margwoz/373WiiFitBoard---TC97_Forked/Maze/Core/Src/main.c

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
/* Includes ------------------------------------------------------------------*/
#include "main.h"

/* USER CODE BEGIN Includes */
#include <math.h>
#include <stdlib.h>
#include <string.h>
#include <stdio.h>
#include "MAX7219Driver.h"
#include "audio.h"
/* USER CODE END Includes */

/* USER CODE BEGIN PD */
#define STEP_SIZE 1.8
#define MAX_ARR 1999
#define MIN_ARR 1499

extern unsigned char output_pcm[];
extern unsigned int output_pcm_len;

/* USER CODE END PD */

DAC_HandleTypeDef hdac1;
DMA_HandleTypeDef hdma_dac1_ch1;

UART_HandleTypeDef hlpuart1;
UART_HandleTypeDef huart5;
UART_HandleTypeDef huart2;

SPI_HandleTypeDef hspi1;

TIM_HandleTypeDef htim3;
TIM_HandleTypeDef htim4;
TIM_HandleTypeDef htim5;
TIM_HandleTypeDef htim6;
TIM_HandleTypeDef htim7;

/* USER CODE BEGIN PV */

int32_t elapsed_time = -1; //start at -1 to handle delay between timer start and display

/* USER CODE END PV */

void SystemClock_Config(void);
static void MX_GPIO_Init(void);
static void MX_DMA_Init(void);
static void MX_USART2_UART_Init(void);
static void MX_UART5_Init(void);
static void MX_LPUART1_UART_Init(void);
static void MX_SPI1_Init(void);
static void MX_TIM4_Init(void);
static void MX_TIM3_Init(void);
static void MX_TIM7_Init(void);
static void MX_TIM6_Init(void);
static void MX_DAC1_Init(void);
static void MX_TIM5_Init(void);
/* USER CODE BEGIN 0 */

// Wireless Transfer Data
int8_t rx_byte[2] = { 0, 0 };
volatile int received_roll = 0;
volatile int received_pitch = 0;
volatile uint8_t msg_flag = 0;
volatile uint8_t mov_flag1 = 0;
volatile uint8_t mov_flag2 = 0;


// Motor Movement Data
volatile int32_t steps_left1 = 0;
volatile int32_t steps_left2 = 0;
volatile int32_t steps_to_take1 = 0;
volatile int32_t steps_to_take2 = 0;
volatile uint32_t current_arr1 = MAX_ARR;
volatile uint32_t current_arr2 = MAX_ARR;
volatile uint32_t arr_step1 = 0;
volatile uint32_t arr_step2 = 0;
volatile int current_roll = 0;
volatile int current_pitch= 0;

//CoM display
volatile int time_update=0; //to actually update time
volatile int clear_flag=0; //clear flag to wipe display between rdy->mov transition

// Game State Data
volatile uint8_t game_ongoing = 0; //start at 0, update to 1 once board status flips

typedef enum
{
	TARE, //taring status from board
	RDY, //ready status from board
	MOV, //moving status from board
	END //game end status from beam break
} player_status; //enum to indicate if someone is on or off the board


player_status board = TARE; //start with the board in taring state


/* USER CODE END 0 */

/**
  * @brief  The application entry point.
  * @retval int
  */
int main(void)
{

  /* MCU Configuration--------------------------------------------------------*/

  /* Reset of all peripherals, Initializes the Flash interface and the Systick. */
  HAL_Init();

  /* Configure the system clock */
  SystemClock_Config();

  /* Initialize all configured peripherals */
  MX_GPIO_Init();
  MX_DMA_Init();
  MX_USART2_UART_Init();
  MX_UART5_Init();
  MX_LPUART1_UART_Init();
  MX_SPI1_Init();
  MX_TIM4_Init();
  MX_TIM3_Init();
  MX_TIM7_Init();
  MX_TIM6_Init();
  MX_DAC1_Init();
  MX_TIM5_Init();
  /* USER CODE BEGIN 2 */

  HAL_UART_Receive_IT(&huart5, rx_byte, 2); //enable reception from the wireless

  Matrix_Init(); //start the display

  HAL_GPIO_WritePin(EN1_GPIO_Port, EN1_Pin, GPIO_PIN_RESET); //enable motor 1
  HAL_GPIO_WritePin(EN2_GPIO_Port, EN2_Pin, GPIO_PIN_RESET); //enable motor 2

  int dir1 = 0; //direction of roll motor
  int dir2 = 0; //direction of pitch motor
  int diff1 = 0; //roll difference
  int diff2 = 0; //pitch difference
  int sign1 = 0; //addition/subtraction (1,-1) for roll
  int sign2 = 0; //addition/subtraction (1,-1) for pitch


  /* USER CODE END 2 */

  /* Infinite loop */
  /* USER CODE BEGIN WHILE */
  while (1)
  {
    /* USER CODE END WHILE */

    /* USER CODE BEGIN 3 */
	  if(board==TARE) //if taring
	  {
		  if(game_ongoing == 1) //if someone stepped off mid game
		  {
			  	if(current_roll!=0) //if roll not zeroed
			  	{
			  		//move motor back to zero
			  		dir1  = (current_roll - 0 > 0) ? 1 : 0;
			  		diff1 = (abs(current_roll - 0));
			  		steps_left1 = steps_to_take1 = 2 * diff1;
			  		arr_step1 = (MAX_ARR - MIN_ARR) / ( (steps_to_take1) / 3 ) ;
			  		HAL_GPIO_WritePin(DIR1_GPIO_Port, DIR1_Pin, dir1);
			  		HAL_TIM_Base_Start_IT(&htim6);
			  		current_roll = 0;
			  	}

			  	if(current_pitch!=0) //if pitch not zeroed
			  	{
			  		//move motor back to zero
			  		dir2  = (current_pitch - 0 > 0) ? 1 : 0;
			  		diff2 = (abs(current_pitch - 0));
			  		steps_left2 = steps_to_take2 = 2 * diff2;
			  		arr_step2 = (MAX_ARR - MIN_ARR) / ( (steps_to_take2) / 3 ) ;
			  		HAL_GPIO_WritePin(DIR2_GPIO_Port, DIR2_Pin, dir2);
			  		HAL_TIM_Base_Start_IT(&htim7);
			  		current_pitch = 0;
			  	}
			  	game_ongoing=0; //reset to game not going
			  	HAL_TIM_Base_Stop_IT(&htim4); //stop timer
			  	elapsed_time = -1; //reset elapsed time
		  }

		  //write TARE to display
		  Write_Char(3,29);//T
		  Write_Char(2,10);//A
		  Write_Char(1,27);//R
		  Write_Char(0,14);//E
	  }

	  else if (board==RDY) //board ready for a user
	  {
		  //Write RDY:) to display
		  Write_Char(3,27);//R
		  Write_Char(2,13);//D
		  Write_Char(1,34);//Y
		  Write_Char(0,38);//:)
	  }

	  else if (board==MOV) //user on board
	  {
		  if (clear_flag) //if just transitioned from the rdy state
		  {
				HAL_TIM_Base_Start_IT(&htim4); //start timer
				Matrix_Clear(); //clear matrix
				Write_Char(3,0); //0
				Write_Char(2,0); //0
				Write_Char(1,0); //0
				clear_flag=0; //reset flag
		  }

		  //Update motors
		  if(msg_flag && !( mov_flag1 | mov_flag2 ) ) {
		 		  dir1  = (current_roll - received_roll > 0) ? 1 : 0; //roll direction logic
		 		  dir2  = (current_pitch - received_pitch > 0) ? 1 : 0; //pitch direction logic

		 		  //determine if we're adding or subtracting
		 		  sign1 = (dir1 == 0) ? 1 : -1; //get roll sign based on dir
		 		  sign2 = (dir2 == 0) ? 1 : -1; //get pitch sign based on dir

		 		  diff1 = (abs(current_roll - received_roll)); //get the roll delta
		 		  diff2 = (abs(current_pitch - received_pitch)); //get the pitch delta

		 		  //*2 bc using toggle so need 1 to turn on and 1 to turn off
		 		  steps_left1 = steps_to_take1 = 2 * diff1; //roll steps
		 		  steps_left2 = steps_to_take2 = 2 * diff2; //pitch steps

		 		  //Update ARR steps based on step range
		 		  arr_step1 = (MAX_ARR - MIN_ARR) / ( (steps_to_take1) / 3 ) ;
		 		  arr_step2 = (MAX_ARR - MIN_ARR) / ( (steps_to_take2) / 3 ) ;

		 		  HAL_GPIO_WritePin(DIR1_GPIO_Port, DIR1_Pin, dir1); //set roll direction
		 		  HAL_GPIO_WritePin(DIR2_GPIO_Port, DIR2_Pin, dir2); //set pitch direction

		 		  // Set move flags
		 		  mov_flag1 = mov_flag2 = 1;

		 		  HAL_TIM_Base_Start_IT(&htim6); //start timer for moving motors
		 		  HAL_TIM_Base_Start_IT(&htim7); //start timer for moving motors
		 		  current_roll += (sign1*diff1); //where roll actually is
		 		  current_pitch += (sign2*diff2); //where pitch actually is
		 	  }
	  }

	  else if(board==END) //board==END
	  {
		  	if(current_roll!=0) //if roll not zeroed
		  	{
		  		dir1  = (current_roll - 0 > 0) ? 1 : 0;
		  		diff1 = (abs(current_roll - 0));
		  		steps_left1 = steps_to_take1 = 2 * diff1;
		  		arr_step1 = (MAX_ARR - MIN_ARR) / ( (steps_to_take1) / 3 ) ;
		  		HAL_GPIO_WritePin(DIR1_GPIO_Port, DIR1_Pin, dir1);
		  		HAL_TIM_Base_Start_IT(&htim6);
		  		current_roll = 0;
		  	}

		  	if(current_pitch!=0) //if pitch not zeroed
		  	{
		  		dir2  = (current_pitch - 0 > 0) ? 1 : 0;
		  		diff2 = (abs(current_pitch - 0));
		  		steps_left2 = steps_to_take2 = 2 * diff2;
		  		arr_step2 = (MAX_ARR - MIN_ARR) / ( (steps_to_take2) / 3 ) ;
		  		HAL_GPIO_WritePin(DIR2_GPIO_Port, DIR2_Pin, dir2);
		  		HAL_TIM_Base_Start_IT(&htim7);
		  		current_pitch = 0;
		  	}

		  	//run audio
			HAL_TIM_Base_Start(&htim5);
			HAL_DAC_Start_DMA(&hdac1, DAC_CHANNEL_1, (uint32_t *)output_pcm, output_pcm_len, DAC_ALIGN_8B_R);

			//display transition
			Write_Char(0,39); //Heart to replace the center of mass w/ final time
			HAL_TIM_Base_Stop_IT(&htim4); //stop timer
			HAL_NVIC_EnableIRQ(UART5_IRQn); //re-enable the UART interrupt
			elapsed_time = -1; //reset elapsed time
	  }

  }

  /* USER CODE END 3 */
}

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
/* USER CODE BEGIN 4 */
#ifdef __GNUC__
#define PUTCHAR_PROTOTYPE int __io_putchar(int ch)
#else
  #define PUTCHAR_PROTOTYPE int fputc(int ch, FILE *f)
#endif /* __GNUC__ */
PUTCHAR_PROTOTYPE
{
  HAL_UART_Transmit(&hlpuart1, (uint8_t *)&ch, 1, 0xFFFF);
  return ch;
}

void HAL_UART_RxCpltCallback(UART_HandleTypeDef *huart)
{
	if(huart->Instance == UART5)
	{

		if(rx_byte[0]==87 && rx_byte[1]==87) //if receiving tare status from the board (status 87)
		{
			board = TARE; //set board status to tare, handle in main
		}

		else if (rx_byte[0]==89 && rx_byte[1]==89) //if received rdy status from the board (status 89)
		{
			board = RDY; //set board status to ready, handle in main
		}

		else //board has someone on it
		{

			//1st transition from RDY -> MOV
			if(board==RDY && game_ongoing==0)
			{
				board = MOV; //update the flag
				clear_flag = 1; //set flag
				game_ongoing = 1; //game has started
			}

		}
		//update received roll and pitch every time but should only move when status is MOV
		received_roll = rx_byte[0]; //update roll
		received_pitch = rx_byte[1]; //update pitch
		msg_flag = 1; //data ready
		HAL_UART_Receive_IT(&huart5, rx_byte, 2); //restart the uart every time no matter what state we're in
	}
}

void HAL_TIM_PeriodElapsedCallback(TIM_HandleTypeDef *htim){

	//Timer for Display (CoM and user time)
	//CoM updates ~20 times as fast as the time does
	//Time updates every second
	if (htim->Instance == TIM4)
	{
		//CoM Display
	    float mass_col = (4*((received_roll/70.0)+1)-1); //get col based on roll
		float mass_row = (4*((received_pitch/70.0)+1)-1); //get row based on pitch
		mass_row = (mass_row > 7) ?  7 : (mass_row < 0) ? 0 : mass_row; //bound checking on row
		mass_col = (mass_col > 7) ? 7 : (mass_col < 0) ? 0 : mass_col; //bound checking on col
		Matrix_Clear_Cell(0); //clear current CoM
		Write_Pixel(0, (int)mass_row, (int)mass_col); //write CoM

		//Time Display
		time_update++; //update universal timer
		if (time_update==20) //if need to update time display
		{
			elapsed_time++; //increase displayed time
			Write_Char(3, (elapsed_time / 100) % 10);
			Write_Char(2, (elapsed_time / 10) % 10);
			Write_Char(1, elapsed_time % 10);
			time_update=0; //reset
		}

	}

	//Timer for Motor 1
	if (htim->Instance == TIM6)
	{
		//If done moving stop/reset timer and clear flag
		if (steps_left1 <=0)
		{
			HAL_TIM_Base_Stop_IT(&htim6);
			TIM6->ARR = MAX_ARR;
			current_arr1 = MAX_ARR;
			mov_flag1 = 0;  //indicate we're ready to move again
		}

		// Accelerate for the first 3rd of steps
		if( steps_left1 <=  (steps_to_take1) * (2/3) ){
			current_arr1 -= arr_step1;
			TIM6->ARR = current_arr1;
		 //Hold speed for middle third
		}
		else if ( steps_left1 >= (steps_to_take1) * (1/3) ){

		 // Decelerate for final third
		}
		else{
			current_arr1 += arr_step1;
			TIM6->ARR = current_arr1;
		}

		if( steps_left1 > 0){
			HAL_GPIO_TogglePin(STP1_GPIO_Port, STP1_Pin);
			steps_left1--;
		}
	}

	//Timer for Motor 2
	if(htim->Instance == TIM7)
	{
		//If done moving stop/reset timer and clear flag
		if (steps_left2 <=0)
		{
			HAL_TIM_Base_Stop_IT(&htim7);
			current_arr2 = MAX_ARR;
			TIM7->ARR = MAX_ARR;
		    mov_flag2 = 0;    //indicate we're ready to move again
		}

		// Accelerate for the first 3rd of steps
		if( steps_left2 <=  (steps_to_take2) * (2/3) ){
			current_arr2 -= arr_step2;
			TIM7->ARR = current_arr2;
		 //Hold speed for middle third
		}else if ( steps_left2 >= (steps_to_take2) * (1/3) ){

		 // Decelerate for final third
		}else{
			current_arr2 += arr_step2;
			TIM7->ARR = current_arr2;
		}

		if(steps_left2 > 0){
		HAL_GPIO_TogglePin(STP2_GPIO_Port, STP2_Pin);
		steps_left2--;
		}
	}
}

//function to clear overrun flag
//added to account for the issue where we receive information before we clear the buffer
//has no affect on actual performance, only on buffer performance
void HAL_UART_ErrorCallback(UART_HandleTypeDef *huart)
{
    if (huart->Instance == UART5)
    {
        uint32_t err = HAL_UART_GetError(huart);

        if (err & HAL_UART_ERROR_ORE)
        {

            __HAL_UART_CLEAR_FLAG(huart, UART_CLEAR_OREF);
            __HAL_UART_SEND_REQ(huart, UART_RXDATA_FLUSH_REQUEST);
        }

        HAL_UART_Receive_IT(huart, rx_byte, 2);
    }
}


//Beam break interrupt code
void HAL_GPIO_EXTI_Callback(uint16_t GPIO_Pin)
{
  if (GPIO_Pin == BEAM_BREAK_Pin) { // GPIO_PIN_0 as beam button is external interrupt on PG0
  		if (game_ongoing) //if game to end
  		{
  			game_ongoing = 0; //game no longer active
  			board = END; //update board status, to be handled in main
  			HAL_NVIC_DisableIRQ(UART5_IRQn); //disable uart until game reset logic done in main
  	}

  }
}

/* USER CODE END 4 */
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
