margwoz/373WiiFitBoard---TC97_Forked/Maze/Core/Inc/main.h

#define BEAM_BREAK_TWO_Pin GPIO_PIN_8
#define BEAM_BREAK_TWO_GPIO_Port GPIOF
#define BEAM_BREAK_TWO_EXTI_IRQn EXTI9_5_IRQn
#define RST1_Pin GPIO_PIN_0
#define RST1_GPIO_Port GPIOC
#define STP1_Pin GPIO_PIN_1
#define STP1_GPIO_Port GPIOC
#define SLP_Pin GPIO_PIN_3
#define SLP_GPIO_Port GPIOC
#define EN1_Pin GPIO_PIN_3
#define EN1_GPIO_Port GPIOA
#define DIR1_Pin GPIO_PIN_4
#define DIR1_GPIO_Port GPIOC
#define CS_Pin GPIO_PIN_12
#define CS_GPIO_Port GPIOF
#define BEAM_BREAK_Pin GPIO_PIN_0
#define BEAM_BREAK_GPIO_Port GPIOG
#define BEAM_BREAK_EXTI_IRQn EXTI0_IRQn
#define EN2_Pin GPIO_PIN_3
#define EN2_GPIO_Port GPIOD
#define STP2_Pin GPIO_PIN_4
#define STP2_GPIO_Port GPIOD
#define DIR2_Pin GPIO_PIN_7
#define DIR2_GPIO_Port GPIOD
