margwoz/373WiiFitBoard---TC97_Forked/FitnessBoard/Core/Src/main.c

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
/* Includes ------------------------------------------------------------------*/
#include "main.h"

/* USER CODE BEGIN Includes */
#include "hx711.h"
#include "stdio.h"

/* USER CODE END Includes */

/* USER CODE BEGIN PD */
#define COEF1 6067.3
#define COEF2 5985.7
#define COEF3 6045.2
#define COEF4 5979.8
//Max amount of steps to normalize roll/pitch to. Increase for higher sense (careful not to over-rotate)
#define STEP_NORM 70.1 //MUST FIT IN int8_t [-128 to 127]
//Transmission CMDS (Outside of max normalized step boundary)
#define CMD_TARE 87
#define CMD_RDY 89
//Thresholds for state transition logic
#define PLAY_THRSH 10
#define MOVE_THRSH 5
#define TARE_THRSH 0.5
//Iteration counts for measurement samples and tare cycles
#define NUM_TARES 25
#define NUM_SAMPLES 1
//Dead zones for amplifier noise
#define LOWER_DZ 0.5
#define UPPER_DZ 500
//Tear delay in ms
#define TARE_DELAY 2000
#define PLAY_DELAY 1000
/* USER CODE END PD */

UART_HandleTypeDef huart2;
UART_HandleTypeDef huart6;

/* USER CODE BEGIN PV */
//Cell Init
hx711_t cell1, cell2, cell3, cell4;
//State machine for tare, ready, and play states
typedef enum {
	TARE,
	RDY,
	PLAY
} state_t;
//Status print array
const char *state_names[] = { "TARE", "RDY ", "PLAY" };
//Empty tick for tare delay
uint32_t tare_timer_start = 0;
uint32_t play_timer_start = 0;

/* USER CODE END PV */

void SystemClock_Config(void);
static void MX_GPIO_Init(void);
static void MX_USART2_UART_Init(void);
static void MX_USART6_UART_Init(void);
/**
 * @brief  The application entry point.
 * @retval int
 */
int main(void) {

	/* MCU Configuration--------------------------------------------------------*/

	/* Reset of all peripherals, Initializes the Flash interface and the Systick. */
	HAL_Init();

	/* Configure the system clock */
	SystemClock_Config();

	/* Initialize all configured peripherals */
	MX_GPIO_Init();
	MX_USART2_UART_Init();
	MX_USART6_UART_Init();
	/* USER CODE BEGIN 2 */
	//Cell1
	hx711_init(&cell1, clk1_GPIO_Port, clk1_Pin, cell1_GPIO_Port, cell1_Pin);
	hx711_coef_set(&cell1, COEF1); // read after calibration
	HAL_Delay(10);
	//Cell2
	hx711_init(&cell2, clk2_GPIO_Port, clk2_Pin, cell2_GPIO_Port, cell2_Pin);
	hx711_coef_set(&cell2, COEF2); // read after calibration
	HAL_Delay(10);
	//Cell3
	hx711_init(&cell3, clk3_GPIO_Port, clk3_Pin, cell3_GPIO_Port, cell3_Pin);
	hx711_coef_set(&cell3, COEF3); // read after calibration
	HAL_Delay(10);
	//Cell4
	hx711_init(&cell4, clk4_GPIO_Port, clk4_Pin, cell4_GPIO_Port, cell4_Pin);
	hx711_coef_set(&cell4, COEF4); // read after calibration
	HAL_Delay(10);

	//Initial tare before while()
	HAL_Delay(500);
	hx711_tare(&cell1, NUM_TARES);
	hx711_tare(&cell2, NUM_TARES);
	hx711_tare(&cell3, NUM_TARES);
	hx711_tare(&cell4, NUM_TARES);

	//Initial state
	state_t status = RDY;
	int8_t buffer[2] = { 0 };
	float weight1, weight2, weight3, weight4;
	/* USER CODE END 2 */

	/* Infinite loop */
	/* USER CODE BEGIN WHILE */
	while (1) {
		/* USER CODE END WHILE */

		/* USER CODE BEGIN 3 */
		//Wait for weight threshold
		weight1 = hx711_weight(&cell1, NUM_SAMPLES);
		weight2 = hx711_weight(&cell2, NUM_SAMPLES);
		weight3 = hx711_weight(&cell3, NUM_SAMPLES);
		weight4 = hx711_weight(&cell4, NUM_SAMPLES);

		//HALF LB dead zone
		if (weight1 < LOWER_DZ || weight1 > UPPER_DZ) weight1 = 0;
		if (weight2 < LOWER_DZ || weight2 > UPPER_DZ) weight2 = 0;
		if (weight3 < LOWER_DZ || weight3 > UPPER_DZ) weight3 = 0;
		if (weight4 < LOWER_DZ || weight4 > UPPER_DZ) weight4 = 0;

		//Calculate sum (NO DIVIDE BY 0)
		float sum = weight1 + weight2 + weight3 + weight4;

		//Pitch and roll math (NORMALIZED)
		int8_t pitch = 0;
		int8_t roll = 0;
		if (sum > 0) {
			pitch = STEP_NORM * (((weight1 + weight4) - (weight2 + weight3)) / sum);
			roll = STEP_NORM * (((weight1 + weight2) - (weight3 + weight4)) / sum);
		}

		//Test print
		//printf("cell1: %.2f | cell2: %.2f | cell3: %.2f | cell4: %.2f <-> roll: %i | pitch %i <-> STATUS: %s\n",
		//		weight1, weight2, weight3, weight4, buffer[0], buffer[1], state_names[status]);

		//State machine for TARE, RDY, and PLAY states
		switch (status) {
		  case TARE:
			//TARE transmission
			buffer[0] = CMD_TARE;
			buffer[1] = CMD_TARE;
			//Transmit command, wait for tare
			HAL_UART_Transmit(&huart6, (uint8_t*) buffer, 2, 100);
			hx711_tare(&cell1, NUM_TARES);
			HAL_UART_Transmit(&huart6, (uint8_t*) buffer, 2, 100);
			hx711_tare(&cell2, NUM_TARES);
			HAL_UART_Transmit(&huart6, (uint8_t*) buffer, 2, 100);
			hx711_tare(&cell3, NUM_TARES);
			HAL_UART_Transmit(&huart6, (uint8_t*) buffer, 2, 100);
			hx711_tare(&cell4, NUM_TARES);
			//Update status
			status = RDY;
			break;

		  case RDY:
			//RDY transmission
			buffer[0] = CMD_RDY;
			buffer[1] = CMD_RDY;
			HAL_UART_Transmit(&huart6, (uint8_t*) buffer, 2, 100);
			//PLAY threshold
			if (sum > PLAY_THRSH) {
				if (play_timer_start == 0) {
					//start timer
					play_timer_start = HAL_GetTick();
				} else if (HAL_GetTick() - play_timer_start >= PLAY_DELAY) {
					status = PLAY;
					play_timer_start = 0;
				}
			} else {
				play_timer_start = 0;
			}
			break;

		  case PLAY:
			//Motor movement threshold
			if (sum > MOVE_THRSH && sum > 0) {
			  buffer[0] = pitch;
			  buffer[1] = roll;
			  //board not empty, reset tare delay
			  tare_timer_start = 0;
			} else {
			  buffer[0] = 0;
			  buffer[1] = 0;
			}
			//PLAY transmission
			HAL_UART_Transmit(&huart6, (uint8_t*) buffer, 2, 100);
			//TARE threshold
			if (sum <= TARE_THRSH) {
			  if (tare_timer_start == 0) {
				  //start timer
				  tare_timer_start = HAL_GetTick();
			  } else if (HAL_GetTick() - tare_timer_start >= TARE_DELAY) {
				  status = TARE;
				  tare_timer_start = 0;
			  }
			} else {
				tare_timer_start = 0;
			}
			break;
		}
	}
	/* USER CODE END 3 */
}

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
/* USER CODE BEGIN 4 */
#ifdef __GNUC__
#define PUTCHAR_PROTOTYPE int __io_putchar(int ch)
#else
#define PUTCHAR_PROTOTYPE int fputc(int ch, FILE *f)
#endif /* __GNUC__ */
PUTCHAR_PROTOTYPE {
	HAL_UART_Transmit(&huart2, (uint8_t*) &ch, 1, 0xFFFF);
	return ch;
}

/* USER CODE END 4 */
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
