margwoz/373WiiFitBoard---TC97_Forked/Maze/Core/Inc/audio.h

unsigned char output_pcm[] = {
  0x7f, 0x7f, 0x7f, 0x7f, 0x7f, 0x7f, 0x7f, 0x7f, 0x7f, 0x7f, 0x7f, 0x7f,
  0x7f, 0x7f, 0x7f, 0x7f, 0x7f, 0x7f, 0x7f, 0x7f, 0x7f, 0x7f, 0x7f, 0x7f,
  0x7f, 0x7f, 0x7f, 0x7f, 0x7f, 0x7f, 0x7f, 0x7f, 0x7f, 0x7f, 0x7f, 0x7f,
  0x7f, 0x7f, 0x7f, 0x7f, 0x7f, 0x7f, 0x7f, 0x7f, 0x7f, 0x7f, 0x7f, 0x7f,
  0x7f, 0x7f, 0x7f, 0x7f, 0x7f, 0x7f, 0x7f, 0x7f, 0x7f, 0x7f, 0x7f, 0x7f,
  0x7f, 0x7f, 0x7f, 0x7f, 0x7f, 0x7e, 0x7f, 0x7e, 0x7f, 0x7e, 0x7f, 0x7e,
  0x7f, 0x7e, 0x7f, 0x7f, 0x7e, 0x7f, 0x7e, 0x7f, 0x7e, 0x7f, 0x7e, 0x7f,
  0x7e, 0x7f, 0x7e, 0x7f, 0x7e, 0x7e, 0x7f, 0x7e, 0x7e, 0x7e, 0x7f, 0x7e,
  0x7f, 0x7e, 0x7f, 0x7f, 0x7e, 0x7f, 0x7e, 0x7f, 0x7e, 0x7f, 0x7f, 0x7f,
  0x7e, 0x7f, 0x7f, 0x7e, 0x7f, 0x7e, 0x7f, 0x7e, 0x7f, 0x80, 0x7f, 0x7e,
  0x7f, 0x7f, 0x7e, 0x7f, 0x7f, 0x7f, 0x7e, 0x7f, 0x7f, 0x7e, 0x7f, 0x7e,
  0x7e, 0x7f, 0x7e, 0x7f, 0x7f, 0x7e, 0x7f, 0x7e, 0x7f, 0x7e, 0x7f, 0x7f,
  0x7e, 0x7e, 0x7f, 0x7e, 0x7f, 0x7e, 0x7e, 0x7f, 0x7e, 0x7f, 0x7e, 0x7f,
  0x7f, 0x7e, 0x7f, 0x7e, 0x7f, 0x7e, 0x7f, 0x7e, 0x7f, 0x7e, 0x7f, 0x7f,
  0x7f, 0x7e, 0x7f, 0x7f, 0x7e, 0x7f, 0x7f, 0x7f, 0x7e, 0x7e, 0x7f, 0x7f,
  0x7f, 0x7e, 0x7f, 0x7f, 0x7e, 0x7d, 0x80, 0x7f, 0x7e, 0x7f, 0x7e, 0x7f,
  0x7e, 0x7e, 0x80, 0x7f, 0x7d, 0x7e, 0x7f, 0x80, 0x7c, 0x7e, 0x81, 0x7e,
  0x7e, 0x7e, 0x7f, 0x7f, 0x7d, 0x7f, 0x7f, 0x7e, 0x7f, 0x7e, 0x7f, 0x7e,
  0x7e, 0x80, 0x7e, 0x7e, 0x7e, 0x7f, 0x7f, 0x7e, 0x7f, 0x7f, 0x7e, 0x7e,
  0x7f, 0x7f, 0x7f, 0x7e, 0x80, 0x7f, 0x7e, 0x7e, 0x7f, 0x80, 0x7d, 0x7f,
  0x7f, 0x7f, 0x7e, 0x7f, 0x7f, 0x7f, 0x7e, 0x7f, 0x7f, 0x7f, 0x7e, 0x7e,
  0x7f, 0x7e, 0x7f, 0x7f, 0x7f, 0x7e, 0x7e, 0x7f, 0x7e, 0x7f, 0x7e, 0x7e,
  0x7f, 0x7f, 0x7e, 0x7f, 0x7f, 0x7e, 0x7e, 0x7f, 0x7f, 0x7e, 0x7f, 0x7e,
  0x7f, 0x7e, 0x7e, 0x80, 0x7f, 0x7e, 0x7f, 0x7f, 0x80, 0x7c, 0x7f, 0x80,
  0x7e, 0x7f, 0x7e, 0x81, 0x7e, 0x7d, 0x81, 0x7f, 0x7e, 0x7e, 0x80, 0x82,
  0x7d, 0x7e, 0x81, 0x7f, 0x7e, 0x7e, 0x80, 0x7f, 0x7d, 0x7e, 0x80, 0x80,
  0x7d, 0x7d, 0x80, 0x7e, 0x7d, 0x80, 0x80, 0x7e, 0x7d, 0x7f, 0x7f, 0x7e,
  0x7e, 0x7f, 0x7f, 0x7e, 0x7e, 0x7f, 0x7f, 0x7d, 0x7e, 0x80, 0x7f, 0x7e,
  0x7f, 0x7e, 0x7e, 0x7e, 0x7f, 0x7f, 0x7e, 0x7f, 0x7f, 0x7e, 0x7f, 0x7e,
  0x80, 0x7f, 0x7e, 0x7f, 0x7f, 0x7f, 0x7e, 0x7f, 0x7f, 0x7e, 0x7f, 0x7f,
  0x7f, 0x80, 0x7d, 0x7e, 0x80, 0x7e, 0x7e, 0x7e, 0x80, 0x7e, 0x7e, 0x80,
  0x80, 0x7f, 0x7e, 0x7e, 0x81, 0x7f, 0x7e, 0x80, 0x80, 0x7e, 0x7d, 0x81,
  0x80, 0x7e, 0x7e, 0x7f, 0x7f, 0x7e, 0x7d, 0x80, 0x81, 0x7d, 0x7e, 0x81,
  0x80, 0x7a, 0x81, 0x81, 0x7d, 0x7d, 0x7f, 0x82, 0x7e, 0x7d, 0x7f, 0x7f,
  0x7e, 0x7b, 0x80, 0x82, 0x7a, 0x7e, 0x80, 0x81, 0x7e, 0x7d, 0x83, 0x7e,
  0x7d, 0x80, 0x7f, 0x81, 0x7c, 0x7e, 0x81, 0x7f, 0x7e, 0x7e, 0x82, 0x7f,
  0x7d, 0x80, 0x7e, 0x7f, 0x7f, 0x7e, 0x81, 0x80, 0x7f, 0x7f, 0x7f, 0x7f,
  0x7e, 0x80, 0x80, 0x7e, 0x7f, 0x7f, 0x7e, 0x7f, 0x7f, 0x7f, 0x7f, 0x7e,
  0x7f, 0x7e, 0x7f, 0x7e, 0x7f, 0x7f, 0x7e, 0x7e, 0x81, 0x7f, 0x7e, 0x7f,
  0x7f, 0x7f, 0x7e, 0x7f, 0x81, 0x7f, 0x7d, 0x7e, 0x82, 0x80, 0x7b, 0x7f,
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
};
unsigned int output_pcm_len = 48305;
