margwoz/373WiiFitBoard---TC97_Forked/(commit log)

2026-04-05 Wireless Transmit Test
2026-04-12 Maze code with hardware timer for the motors
2026-04-15 Add files via upload
    Fit Board code for Amps w/ F401RE
2026-04-15 Add files via upload
    adds acceleration to motors and display broke hooray!
2026-04-15 Beam Button Test
2026-04-18 board side of 4-16
2026-04-19 Final Maze Side Driver
2026-04-19 rm old board directory
2026-09-23 Rename Final Wii Fit Board Electronics - Interior.png to images/Final Wii Fit Board Electronics - Interior.png
2026-09-23 Rename Import button.png to images/Import button.png
2026-09-23 Rename Final Wii Fit Board Electronics - Interior.png to boardInterior.png
2026-09-23 Rename Import button.png to ImportButton.png
